ebelski/rust-copter/(list of files, cad)

Other CAD files:
solid-models/motor-test-fixture/motor_test_fixture.step
solid-models/motor-test-fixture/motor_test_fixture.stl
