ebelski/rust-copter/solid-models/motor-test-fixture/readme.md

solid models in this file are used for single motor testing so that the motor does not jump around on the bench or takeoff!
