ebelski/rust-copter/(threads)

Thread 5 (2020-03-18):

Reset to 0% throttle, not duty cycle

mciantyre, 2020-03-18:
In the `pwm-control` demo, pressing the SPACE bar commands 0% duty cycle, not 0% throttle. This is equivalent to removing the physical connection between the ESC and the controller. We're concerned that completely dropping the ESC input signal will cause a stall.

Update the SPACE bar to command 0% throttle, or 50% duty cycle. Move the kill switch to the backslash key, `\`.

Closed 2020-03-24.

Thread 7 (2020-06-04):

Running pwm-control.bat fails to produce hex file

ebelski, 2020-06-04:
@mciantyre , when running the hardware-test.bat file under the **demos** -> **pwm-control**, the compilation succeeds however the .hex file does not get produced. If the **hardware-test.sh** script is then executed directly after, the **out** folder with the associated hex file is correctly produced.

`The system cannot find the file specified.
Failed with error code 2.`

mciantyre, 2020-06-04:
Sorry I never tested the `hardware-test.bat` script!

Remove `@echo off` at the top of the script. Does that help identify where we're failing?

Couple of things we can manually check:

- show that `rmdir /S /Q out` works when `out` exists, and when `out` doesn't exist.
- show that `cargo build --release` creates a `target\thumbv7em-none-eabihf\release\pwm_control` file. If not, the `copy` command (line 14) is failing.
- try `arm-none-eabi-objcopy --help`. If it fails, we'll need to troubleshoot the toolchain installation.

ebelski, 2020-06-04:
We're failing on `rmdir /S /Q out` when out doesn't exist

ebelski, 2020-06-04:
I changed the line to read `if exist out rmdir /S /Q out || goto :error` and it looks like we're functional with or without the out directory existing.

mciantyre, 2020-06-04:
Awesome! I'll patch that upstream. Thanks for testing this.

Closed 2020-06-04.

Thread 8 (2020-06-04):

Use serial communication for PWM control demo

mciantyre, 2020-06-04:
We're having trouble using USB comms when connecting all the motors. Use UART as the communication mechanism.

ebelski, 2020-06-07:
Just as a follow up, I was able to get the USB comms working but it required me to plug the Power Supply into a different power outlet and plug the Teensy USB into a different USB outlet on my PC....

ebelski, 2020-06-10:
Do we still require the ability to communicate over UART? With USB back up and running I don't have a need for it currently.

ebelski, 2020-06-11:
Closing for now

Closed 2020-06-11.

Thread 9 (2020-06-04):

What serial communication cable do we need to communicate with the Teensy 4.0?

ebelski, 2020-06-04:
This one?

https://www.sparkfun.com/products/9717

ebelski, 2020-06-04:
https://www.adafruit.com/product/70

I ordered this one. Will reopen if necessary

ebelski, 2021-04-06:
Install the attached drivers to allow the cable to act as a virtual COM port. Link in the description to the drivers. Select the appropriate one for your OS and hardware.

Closed 2020-06-04.

Thread 13 (2020-06-10):

Error in task.py

ebelski, 2020-06-10:
```
python task.py demo pwm-control
error: Invalid character `{` in pkgid: `{crate}`
Traceback (most recent call last):
  File "task.py", line 165, in <module>
    args.func(args)
  File "task.py", line 114, in demo
    target = _cargo_build(crate, args.release)
  File "task.py", line 96, in _cargo_build
    subprocess.run(cmd, shell=True, check=True, env=env)
  File "C:\Anaconda3\lib\subprocess.py", line 418, in run
    output=stdout, stderr=stderr)
subprocess.CalledProcessError: Command 'cargo build --target thumbv7em-none-eabihf --release --package {crate}' returned non-zero exit status 101.
```

mciantyre, 2020-06-10:
Which version of Python is bundled with your Anaconda distribution?

```
python --version
```

Is it yelling about the f-string interpolation character, `{`? [f-strings](https://www.python.org/dev/peps/pep-0498/) are a Python 3.6 feature.

ebelski, 2020-06-10:
3.6.5.

It's not passing the actual crate name, instead it's getting a literal `{crate}` in the command line

ebelski, 2020-06-10:
I think the issue lies with line 96 in task.py?

mciantyre, 2020-06-10:
This is a good catch! Just reproduced on `master`. But, I can't reproduce it on the `feature/esc-protocols` brach...?

ebelski, 2020-06-10:
There was no `f` prefix in front of the string on line 93 so it should now read `    if crate:
        cmd += f" --package {crate}"`

I'm trying that to see if it works

mciantyre, 2020-06-10:
Looks like it! Want to push a fix? Otherwise I can grab it.

I'll add some automated tests that will run

```
python task.py demo pwm-control
```

on PRs, so these kinds of bugs don't happen again.

ebelski, 2020-06-10:
I'll push an update to the repo

Closed 2020-06-10.

Thread 15 (2020-06-10):

Print fixture to hold motor during OneShot testing.

ebelski, 2020-06-10:
The torque from the motor causes it to jump around on the desktop when spinning so it needs fixed in place to prevent damage to the electronics.

Closed 2020-06-10.

Thread 20 (2020-06-11):

Mount 3 motors simultaneously on the PDB and verify functionality

ebelski, 2020-06-11:

ebelski, 2020-06-11:
only testing 3 motors because one ESC is verified as bad.

ebelski, 2020-08-14:
I soldered the remaining 2 ESCs and motors to the PDB board. I powered on the Teensy and verified that each ESC powers on properly and then I commanded all motors to spin at 5% duty cycle. Everything functions well so far. I'll place an order for another ESC.

Closed 2020-08-14.

Thread 21 (2020-06-11):

Map PWM throttle percentages

ebelski, 2020-06-11:
Map PWM throttle percentages to current draw as measured by the power supply. Knowledge of the current drawn by the motor allows the force exerted by the motor/prop combo to be inferred

ebelski, 2020-06-11:
I created a spreadsheet to track this but don't know if it will upload well to github. @mciantyre if you have any suggestions for how to bring in a google sheet eloquently, that'd be much appreciated!

Otherwise, here's what I found.
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

I stopped at 55% throttle for 2 reasons. One, I have my power supply limited to 5.5 A current and I didn't want to saturate the supply. Two, this motor was getting pretty rowdy so I didn't want to push it just yet. I'm hoping that this half of the curve will be an ok approximation of the actual force/throttle curve.

Here's a chart of the current supplied vs. throttle percent.
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

So far it looks as if a 3rd order polynomial represents the curve rather well. The only doubts that I have in the data are from the specified parameters of the motor. It calls out for our setup (2300 KV, 14.8V, 5045 prop):

- a max current load of 27.6 A (the predicted current of 100% throttle is about 24 A or a 13% difference. I could be convinced that this is within their manufacturing tolerances, however I think it is due to nonlinear torque curves as the motor reaches its maximum rated current.)
- and corresponding to the maximum current, the maximum predicted pull in grams is only 814, not 950. (I don't know why this is specified in grams, it should be specified in Newtons in my opinion or at least mN) Again this could be a tolerance issue but is more likely a nonlinear relationship. We won't know unless we measure at 100% throttle, however I don't have a way to inject 27.6 A and measure it.

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

ebelski, 2020-06-11:
Even a rough model will be useful in developing a state estimator control scheme. Obviously the more accurate the model the better, but I think even a 13% discrepancy is something the control loop will be robust to.

mciantyre, 2020-06-11:
LGTM!

> have any suggestions for how to bring in a google sheet [...]

- If the document can be made public, we can add a link in this issue.
- We export the sheet as a CSV, and check that into the repo. We'll treat is as read only.
- Check in the raw data, and create a Python script to auto-generate the derived data and that plot.

Any option is good with me!

ebelski, 2020-06-11:
<iframe src="https://docs.google.com/spreadsheets/d/e/2PACX-1vRwAtvcS9hT733l32kDBAb9rSdvrcgj9SYalw7AGWiev5Jk97nK2Tfy6cE2jeu-qcLKq769bl4RLJjm/pubhtml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"></iframe>

ebelski, 2020-06-12:
This issue still bothers me slightly. We're relying on the specs from this manufacturer...which I don't outright trust. We can go the more robust route and actually measure the force with a load cell

- https://www.sparkfun.com/products/14729
- https://www.sparkfun.com/products/13879

and create a true calibration of throttle percentage to force. I don't actually think this is necessary but let's keep this idea in the back of our minds should we need a more accurate quadcopter model.

Closed 2020-06-12.

Thread 23 (2020-06-11):

Cleanup documentation

ebelski, 2020-06-11:
Document all of the progress made so far, clean up some of the descriptions in the readme, and begin laying out the wiki.

mciantyre, 2020-06-12:
Count me in. I have some other developer docs to add. I may add the following to the README, just as a reminder for us and for any newcomers:

## Generating source documentation

If you want to see the rendered in-source documentation, run

```
cargo doc --all --open
```

at the top of the repo. When the command finishes, it should open your browser with the documentation to a crate in the repo. Use the "Crates" column on the left to jump to the documentation for any other crate. Helpful crate docs include

- demo_pwm_control, which has the PWM pinout, and a depiction of how an ESC protocol is represented with a PWM signal
- teensy4_bsp, which has a sparse table describing the Teensy 4's pinout and pin functions

We put other software-related notes, tests, and examples in the source docs.  When we run tests, the compiler will check the tests and examples in the documentation for correctness. So by default, we're guaranteed that code samples in documentation are buildable. You'll never copy-and-paste broken code.

ebelski, 2020-06-12:
For sure!

What type of organization paradigm are you thinking for the source docs? Will those live as readmes in the repo?

ebelski, 2020-06-12:
Ultimately, once we get near the end of the build (much further in the future) I'd like for us to author a detailed paper on the process and methodology we took. So I'm game for any organizational scheme that is easy to interpret and useful.

mciantyre, 2020-06-12:
We'll want to keep detailed, module-level software docs in source code, as they are now. The `cargo doc` workflow is the de-facto way for sharing Rust code documentation.

For things like architectures, test plans and results, design docs, I see a few options:

- GitHub Wikis. Edit them in the browser. We can also [treat them as another git repo](https://help.github.com/en/github/building-a-strong-community/adding-or-editing-wiki-pages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), and edit the contents locally. Could be a good starting point.
- [Sphinx](https://www.sphinx-doc.org/en/master/) is flexible. I don't think it'd be something we would ever outgrow. It would help us organize and cross-reference our docs.
- If the goal is a paper, could start up-front with raw LaTeX! But, Sphinx also outputs LaTeX for PDF generation.

mciantyre, 2020-06-12:
On second thought, I might replace GitHub Wiki with “Markdown flies checked into the main repo.” It’s easier for us to version and release documentation with code, data, and models if it’s all in one repo. It’s also easier to look back and see how the project evolved through one version control history.

ebelski, 2020-06-12:
I like the idea of using markdown files stored and versioned in the main repo!

mciantyre, 2020-08-01:
mciantyre/teensy4-rs#74 shows that we can build and publish API documentation from a GitHub repo. The process publishes the content to https://mciantyre.github.io/teensy4-rs/. We could do something similar here. We'll need to figure out how it plays with the current GitHub pages publication.

Thread 24 (2020-06-12):

Develop test fixture for single motor pivot demo

ebelski, 2020-06-12:
The goal of the v0.1 milestone is to develop a demo that combines the motor control with sensor feedback from the mpu-9250.

In order to accomplish this goal we need a fixture to hold the motor at the end of a pivot as well as a pivot joint that can be affixed to the bench.

ebelski, 2020-09-18:
#29

ebelski, 2020-09-18:
https://cad.onshape.com/documents/092c9ad021a8f9693cfda00a/w/540c3cb33ba7e44cbc012b26/e/5458e5c9358795ed5e9bfd87

ebelski, 2021-04-08:
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

ebelski, 2021-05-03:
Constructed arm fixture out of cardboard and a dowel rod.
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

ebelski, 2021-09-20:
The cardboard was actually too heavy. Once I determine the length of each arm of our airframe and cut them, I'll use one of the arms (carbon fiber tube) to test the single motor pivot.

Closed 2023-04-21.

Thread 28 (2020-08-14):

Solder final ESC and motor into PDB

ebelski, 2020-08-14:
Once the spare ESCs arrive, solder the final ESC onto the PDB and test its functionality.

ebelski, 2020-08-17:
Soldered in the last motor and ESC! We're up and running and I verified all motors spin simultaneously

Closed 2020-08-17.

Thread 39 (2021-04-06):

Issue with teensy_loader_cli

ebelski, 2021-04-06:
I downloaded the teensy_loader_cli mentioned in the readme and ran into the following issue running both the cli by itself as well as the task.py.
```bash
python task.py demo pwm-control
    Finished release [optimized] target(s) in 0.02s
Unknown MCU type "TEENSY40"
Supported MCUs are:
 - at90usb162
 - atmega32u4
 - at90usb646
 - at90usb1286
 - mkl26z64
 - mk20dx128
 - mk20dx256
 - mk66fx1m0
 - mk64fx512
 - TEENSY2
 - TEENSY2PP
 - TEENSYLC
 - TEENSY30
 - TEENSY31
 - TEENSY35
 - TEENSY36
Traceback (most recent call last):
  File "task.py", line 166, in <module>
    args.func(args)
  File "task.py", line 117, in demo
    if not args.flash or not _flash(hex_file):
  File "task.py", line 58, in _flash
    subprocess.run(cmd, shell=True, check=True)
  File "/usr/lib/python3.8/subprocess.py", line 512, in run
    raise CalledProcessError(retcode, process.args,
subprocess.CalledProcessError: Command 'teensy_loader_cli --mcu=TEENSY40 -w -v target/thumbv7em-none-eabihf/release/demo-pwm-control.hex' returned non-zero exit status 1.
```

Is there a way to update the version of the cli to support 4.0?

ebelski, 2021-04-06:
I should also add that I tried specify the mcu as `--mcu=imxrt1062` as well

ebelski, 2021-04-06:
I'm closing this for now. I'm going to development on windows but after we reach a somewhat steady state, maybe v0.2 or v0.3, I'd like to run through setting this up on linux.

mciantyre, 2021-04-06:
See [their project](https://github.com/PaulStoffregen/teensy_loader_cli)'s issue tracker. I'm not sure they're releasing prebuilt binaries with Teensy 4 support right now.

It's a quick build from source. The dependencies for Ubuntu are listed under "Compiling from Source":

```
sudo apt-get install libusb-dev
git clone https://github.com/PaulStoffregen/teensy_loader_cli.git
cd teensy_loader_cli
git checkout 0a9ad5f
make
```

After that, you should find `teensy_loader_cli` in the directory. Try listing MCUs:

```
./teensy_loader_cli --list-mcus
```

mciantyre, 2021-04-06:
If there's still issues, the [graphical loader application](https://www.pjrc.com/teensy/loader.html) should work on Linux.

ebelski, 2021-04-06:
I was still running into issues with the graphical loader on Ubuntu but I think it is an issue on my part. I've reverted to using Windows and everything is working for me now.

Closed 2021-04-06.

Thread 42 (2021-04-08):

Milestone 0.1 demo program

ebelski, 2021-04-08:
In order to reach milestone 0.1 we need to be able to demonstrate single motor control based on sensor readings from the MPU-9250. The physical setup will be a lever attached to the desk via a pivot with a motor, propeller, and sensor at the end. The motor/prop will move the lever up and down. We need an example rust demo with the following program flow

- Allow serial input from the command line to choose which gyro axis sensor reading we would like to use as feedback
- Allow serial input for the command line to set the PID gains
- Start the demo with a keystroke and wait for input as the set point
- Allow serial input for the angle (in degrees) that we would like as the set point
    - It would be nice to be able to change the setpoint during the demo but not a requirement

Internal to the program we should:
- Create a control loop where the setpoint is in degrees and the sensor feedback is from the gyroscope.
    - We will need to integrate the velocity to estimate the position of the sensor
    - I will attach a control loop diagram to this issue detailing what we will need to implement

ebelski, 2021-04-08:
#24 shows what the demo fixture will look like

mciantyre, 2021-04-08:
We should re-review the MPU9250 driver code before this experiment, and make sure we can configure the sensor as needed. The current settings are arbitrary.

https://github.com/ebelski/rust-copter/blob/224c5096ab88c62965a70021c66d55af04bf8a7c/firmware/demos-teensy4/pwm-control/sensor.rs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

Where do we think the control loop needs to run? If it can run slowly on our host, we should have most pieces in place to run the experiment. Otherwise, if we need a faster loop, we might need to move it on board.

ebelski, 2021-04-09:
I think, in order to prove out what we eventually might do, that we'll want to get all of the 9 dof readings. Even though we'll only be using the gyro for this demo (at least initially), the quadcopter will likely be using the Madgwick filter or some equivalent where the Magnetometer will important for low frequency correction. By including these readings in the MPU-9250 polling it will give us some insight into what type of latency we can tolerate for the control loop (slower readings = more sluggish response of quadcopter to disturbances).

Is there the possibility of polling the sensor for the different readings at different rates? (e.g. Accel at 2000 Hz, Gyro at say 250 Hz , and Mag at 4 Hz (or whatever the max rate is)) Or are we locked into the slowest rate for all sensors?)

Depending on the answer to the above question, I think it will dictate where we should run the control loop. Another consideration will be the ability to ensure a quasi-deterministic sample rate for the control loop. If host or client side is able to keep time more accurately, we'll probably want to use that unless we have a compelling reason not to.

ebelski, 2021-04-09:
Do we know what the latency of sending sensor measurements from the Teensy to the host over serial would be?

For prototyping purposes, it'd be easier to run the control loop host side in python but I worry about latency. We'd need to pipe the sensor readings from the client to the host, process them, and then send back motor throttle commands. We can definitely give this a shot as I think the development time is relatively low and it will give us an idea if the latency is acceptable.

We would need the following capability in a .hex script

- Pipe accel and gyro readings from the Teensy to my PC
- At the same time read motor throttle commands from my PC and apply them to the respective motor (we only need to actuate 1 motor for this demo)
- (I guess technically this could be done sequentially, where one fires off and waits for a reply before firing again)

We would need the following capability in a python script

- Consume the accel and gryo readings from the Teensy
- Run a semi-deterministic rate control loop to produce a throttle output for the motor
- Pipe the throttle output to the Teensy
- Change the set angle setpoint based on keyboard input

From what we were testing in #29 we have a few of these already done. I can take care of the control loop development in python but I'm not sure how to write the Teensy code or negotiate the communication between the two.

> Where do we think the control loop needs to run? If it can run slowly on our host, we should have most pieces in place to run the experiment...

Based on the above, would it be relatively easy to write up the demo leaving a space for me to plug in the control loop code?

Also what do you think the max rate is that we can run the loop at given this architecture?

ebelski, 2021-04-09:
Green is host side in python and orange is client side in rust
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

mciantyre, 2021-04-10:
> Is there the possibility of polling the sensor for the different readings at different rates?

Yea we can do that. Right now, we're just polling all sensors at the same rate (100Hz) regardless of if the sensor changed. We'll need some changes to the demo's polling loop to support this, or create a better example with this in mind.

> Do we know what the latency of sending sensor measurements from the Teensy to the host over serial would be?

It's not that fast with the current settings.

- 115200 bits per second (baud rate)
- 10 bits per character (8N1: one start, one stop bit, plus 8 data bits)

means it takes `1 / 11520` seconds to send one byte of data.

Given the current serialization schema, 9DOF readings take up 42 bytes. This means it takes ~3.646ms to move 9DOF readings over the serial wire. That still has to go through your OS to reach your control loop. Of course we could tune this specifically for the experiment (variable sensor polling means fewer bytes on the serial wire, for example).

We could try switching the data flow to USB, instead of UART. I'd have to dig deeper into the implementation to see what our latency might be. But hopefully (without a driver change) we could move one 42 byte 9DOF reading every 125us (one bulk transfer every USB high speed microframe, see [here](https://microchipdeveloper.com/usb:frames)).

I can take care of exposing the data to Python, regardless of how it's moving from the board to your PC!

ebelski, 2021-04-12:
Honestly 3.646 ms or 274 Hz might be fast enough for what we're looking to do here in this demo but if we can get data faster that's always welcome! Because we're relying on the propeller/motor response time on a compressible fluid (air), there's probably some inherent speed limitation in how fast we can react to disturbances anyway. However, we'd always want the physics of the mechanical system to be limiting, not the electronics (i.e. blame the wrench monkey who designed the air frame...).

mciantyre, 2021-04-12:
Awesome. #43 makes the move from UART to USB. We're now only using UART for debug logs and human-readable outputs. IMU data streaming, and PWM throttle commands, go through USB.

#43 also adds a Python interface (`pypwm_control`) to stream IMU data, and control the motor throttle. Basic usage might resemble

```python
import pypwm_control

imu, motors = pypwm_control.open("COMx")  # Your COM port

# Disable magnetometer
imu.disable_readings(pypwm_control.ImuReading.Mag)

for reading in imu.stream():
    if type(reading) is pypwm_control.ImuReading.Acc:
        # Handle accelerometer readings
    elif type(reading) is pypwm_control.ImuReading.Gyro:
        # ...

    # Do math in here...

    # Do things with motors
    motors.motor("B").set_throttle(72)  # 72% throttle
```

How does that look for a host-side control loop?

ebelski, 2021-04-12:
Gucci, that's exactly what I was hoping for. Now to see how well I can tune this on the fly with no tools. I think this calls for the [Ziegler-Nichols tuning method](https://en.wikipedia.org/wiki/Ziegler%E2%80%93Nichols_method).

I'll start printing the fixturing for the motor today and plugging in some code.

ebelski, 2021-04-22:
I'm starting to test this but I'm unable to initialize the motor on the quadcopter. I'm using the pwm-control demo on the Teensy and running the following script (which is pretty much what you pseudo coded above)
```python
import pypwm_control

imu, motors = pypwm_control.open("COM3")  # Your COM port

# Disable magnetometer
imu.disable_readings(pypwm_control.ImuReading.Mag)

for reading in imu.stream():
    if type(reading) is pypwm_control.ImuReading.Acc:
        # Handle accelerometer readings
        print(reading)
    elif type(reading) is pypwm_control.ImuReading.Gyro:
        print(reading)

    # Do math in here...

    # Do things with motors
    motors.motor("B").set_throttle(15)  # 72% throttle
```

For the time being I'm just using this to make sure the motor will respond to my inputs. I have everything connected to the power supply and it gives me the startup beep but doesn't give me the connected protocol beep between the ESC and Teensy.

In #12 I recall this working pretty well. Did something change in the firmware that prevents initialization?

ebelski, 2021-04-22:
I'm also trying to use ```esc-throttle.py``` to test the motors and not getting a response from the motor. For reference I'm connected to pin 7 or motor B.

mciantyre, 2021-04-23:
I'm sorry, I'll admit that I haven't tested PWM in a while 😝 I can confirm that PWM output is broken in all of the `rust-copter` code. It's even broken in the [teensy4-rs examples](https://github.com/mciantyre/teensy4-rs).

I think I found the problem in the PWM driver. Once I finish testing, I'll upstream the fix, and propose a temporary patch here. Take a break until I follow up.

ebelski, 2021-04-23:
Ok no worries! I thought it was something I was doing. I'll wait until I hear back from you!

ebelski, 2021-04-23:
@mciantyre fixed this with #46. Progress shall continue! ♟️

ebelski, 2021-04-23:
The python AHRS package contains the Madgwick filter and other Attitude and Heading Reference Systems. pypi.org/project/AHRS/

ebelski, 2021-04-23:
@mciantyre, do you think we would be able to implement some of the AHRS algorithms on the Teensy? Like what Kris Winer has implemented for an Arduino?

https://github.com/kriswiner/MPU9250/blob/72038b040bef3cf072612cd8a8ee8f26e3c87158/MPU9250BasicAHRS.ino

I'd be interested in learning how to implement this if you'd be willing to show me?

Concurrently though I'm working on developing this in python for debugging purposes. So we can wait on this implementation until I iron out a few things regarding the stability of the Madgwick filter.

mciantyre, 2021-04-24:
> do you think we would be able to implement some of the AHRS algorithms on the Teensy? [...] I'd be interested in learning how to implement this if you'd be willing to show me?

Yea for sure! Happy to help you write it for the embedded system. There shouldn't be any problems running an AHRS filter on the board.

There's different ways we can take it:

- Write it all from scratch in either Rust, or C. We can use C code in Rust, and use Rust code in C. Pick whatever you want to learn.
- Use third-party libraries to help with our implementation (like [nalgebra](https://nalgebra.org)).
- Use an existing solution ([kalman filter](https://docs.rs/adskalman/0.8.0/adskalman/), [madgwick filter](https://docs.rs/madgwick/0.1.1/madgwick/)) and integrate it.

ebelski, 2021-09-20:
I ran into a few issues when I was working on the python side of this. I'm hoping to pick this back up again soon.

As an aside, the carbon fiber tubing for the air frame arrived yeserday 🎉

Thread 44 (2021-04-12):

Variable sensor sampling rates

mciantyre, 2021-04-12:
Our 0.1 demo queries all readings (accelerometer, gryoscope, magnetometer) from an MPU9250 at 100Hz. This happens

- regardless of the sensor sampling rate, which might be less than 100Hz
- even if we don't care about that sensor (i.e. we're not using the magnetometer)

There's no reason we're doing this, other than it was simple to put together.

A future embedded platform should support variable sensor sampling rates. This will let us express sensor reading strategies like "poll acc at 2KHz, gyro at 250Hz, and mag at 4Hz."

We should be able to change sampling rates during runtime, before takeoff. Supporting sampling rate changes during flight are not supported. Let me know if changing sensor sampling rates during flight might be useful. I'd need some help thinking through the details.

ebelski, 2021-09-20:
I don't think we need to vary sampling rates during flight. That'd be scary actually 😨 we'd probably get a situation like this

```
A 747 was flying along and was full of Polish people.
As they were going past some beautiful landmarks, the pilot came over
the intercom and instructed all who were interested in seeing the
landmark to look out the right side of the plane. Many
passengers did so, and the plane promply crashed. Why?
Too many poles in the right hand plane.
```

Thread 45 (2021-04-12):

Atomically set PWM outputs

mciantyre, 2021-04-12:
I believe the i.MX RT PWM peripherals could let us set PWM duty cycles atomically across a single peripheral's outputs. This could give us a guarantee that, when we say "set *all* motor throttles to [value]" we've changed the duty cycle for all PWM outputs at *exactly* the same time (within the bounds of a PWM cycle).

We can't express atomic changes with today's driver. We can only loop over the *N* outputs, and set them all to the same throttle. With this API, there's a chance that the first few motors are set to the throttle before the other motors.

This issue tracks atomic changes to PWM outputs.

- [ ] Re-evaluate the peripheral, and see if it's feasible
- [ ] Figure out if this feature is necessary
- [ ] Implement it

mciantyre, 2021-04-12:
Our `ESC` interface already has an API for atomic changes. The default implementation just does the non-optimal loop. If we think that this feature is necessary, let's make sure to design to that API.

https://github.com/ebelski/rust-copter/blob/b12f95fa99cb61595e41ef21fce39d01f53f29ec/common/esc/src/lib.rs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

mciantyre, 2021-04-12:
I'm on the fence between must-have and nice-to-have for this feature. If we were directly driving motors with our PWM outputs, I'd say this is very useful. But, since we're talking to a different ESC today, and we don't control the behaviors on that ESC, I'd think that atomic PWM changes on our end would be an over-optimization.

In practice, I'd expect a loop to set the PWM outputs to happen so fast that it's basically atomic (should verify this). We could prevent software preemption with a critical section.

ebelski, 2021-09-20:
Did you have something in mind for verifying this? Such as connecting it to a logic analyzer?

mciantyre, 2021-09-21:
First thing to verify is that the chip supports a way to atomically set the PWM outputs. Given the description from the fields in this PWM MCTRL register (image below), my interpretation is "yes." I still need to dig in.

Each PWM peripheral supports eight outputs (four submodules, each driving two pins). So to set the values across all eight simultaneously, the flow resembles

1. write `0b1111` to `CLDOK`, or wait for `LDOK` to read zero.
2. [set PWM values for all four outputs in other registers]
3. write `0b1111` to `LDOK`

Once 3 happens, the peripheral loads the PWM values for all outputs, and starts driving with the new values.

Showing this happens with a logic analyzer would be good evidence. But, it wouldn't be complete verification. Today, we can show that we appear to be changing all PWM outputs at the same time; we're lucky.

I'll look into this as I play with the HAL. Could be cool to implement, but still not convinced we need it for today's system.

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

ebelski, 2021-09-23:
I tend to agree that we don't need this. Since we prove (or can prove) that they're setting roughly at the same time, I think that's good enough.

When we start to load the Teensy with more processes we will want to verify this doesn't change.

Thread 47 (2021-04-23):

Revert #46

mciantyre, 2021-04-23:
In #42, Eric found a bug in the PWM driver. We patched it in #46. Revert #46 once the fix is in the upstream HAL, so that we don't have to maintain our own PWM pin multiplexing code. Re-run testing when reverting.

Closed 2021-04-23.
