ebelski/rust-copter/(commit log)

2020-02-02 Add PWM control example
    Use the USB serial connection to command PWM duty cycles.
    As of this commit, only pins 6 and 9, called outputs A and D,
    are implemented.
2020-02-02 Add blinking LED to show something is happening
2020-02-02 Require users to submit a valid percentage
    Don't automatically clamp the percentage. If the user accidentally
    hits an extra '1' when typing '11', that becomes 100%, instead of
    throwing an error about it being out of range. Let's make the user
    enter it again.
    [parser.rs]
2020-02-05 Add remaining PWM outputs; add LED blink
    LED blinks based on the fastest PWM duty cycle. The higher the duty
    cycle, the faster the blink.
2020-02-12 Add PWM kill switch
    Press the SPACE bar to set all PWM outputs to 0%.
2020-02-12 Update MPU example
    Pull in changes from Teensy 4 repo
2020-03-15 Update PWM control demo for ESC PWM protocol
    The commit updates the PWM control demo to command ESCs. It should
    provide an implementation of the standard PWM signal described in
    https://quadmeup.com/pwm-oneshot125-oneshot42-and-multishot-comparison/
    Our ESCs are documented as supporting this PWM protocol. This is not
    the fastest ESC protocol our processor can support; however, it was
    the easiest to implement and verify with a logic analyzer.
    Note that pressing the SPACE bar sets the duty cycle to 0, not the
    throttle percentage. SPACE still acts as a kill switch. But, we set
    the throttle percentage to 0 during start-up.
2020-03-15 Fix logic for converting duty to percentages
    [main.rs]
2020-03-18 Indicate when a motor is disabled
    Pressing the SPACE bar disables all outputs. The commit updates
    the read duty command so that disabled outputs are indicated
    as being DISABLED.
2020-03-18 Reset to 0% throttle, not 0% duty cycle
    [main.rs, parser.rs]
2020-03-18 Add software kill switch
    Pressing the '\' key will set all PWM duty cycles -- not throttles --
    to 0%, and stop the event loop. The user will be required to reset
    the system.
    [main.rs, parser.rs]
2020-06-05 Add ESC interface and naive i.MX RT implementation
2020-06-05 Integrate ESC into pwm-control demo
    Note the updated PWM output table! The motor identifies have changed
    to support the limitations in the ESC implementation.
    Tested as follows:
    - All PWM outputs start at 50% duty cycle (0% throttle)
    - Table of PWM outputs to pins appears to be correct
    - Moved a lead on the logic analyzer one by one, changed the pin
    duty cycle, then read that duty cycle.
    - Pressing 'r' shows the correct duty cycle
    - Pressing 'SPACE' sets throttle to 0%
    - Kill switch still kills
    [main.rs, parser.rs]
2020-06-05 Migrate to a top-level task script
    The new task.py Python script replaces the various hardware-test.sh
    and hardware-test.bat scripts. It's run from the top of the
    repository:
    ./task.py demo pwm-control
    It requires Python 3. See the script's top-level documentation for
    more examples and help.
2020-06-09 Implement additional ESC protocols
    - rename "slow" to "standard"
    - implement OneShot125
    - implement OneShot42
    Implementations just map to a PWM frequency. The ESC type then maps
    a throttle percentage to a duty cycle.
    Move the `kill()` method into the trait.
2020-06-09 Print ESC protocol when reading throttles
2020-06-10 Show that the 'demo-' prefix isn't necessary
    The actual crate names have a 'demo-' prefix. Even though, on the
    filesystem, the directory is called 'pwm-control', the Rust crate
    is called 'demo-pwm-control'. The script should handle missing
    prefixes, just to make it easier for users.
2020-06-10 Uploading motor test fixture step and stl files. Primary use is to secure the motor to the bench when testing it with a prop. Torque is pretty high even without the prop, so I recommend bolting down 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
    [motor_test_fixture.step, motor_test_fixture.stl]
2020-06-10 Track PDFs with git lfs
2020-06-11 Fix tag matching
    GitHub Actions don't support full regex. Here's the limited set of
    possible matches:
    https://help.github.com/en/actions/reference/workflow-syntax-for-github-actions#filter-pattern-cheat-sheet
2020-06-12 Create readme.md in motor-test-fixture folder
2020-06-12 Resolve merge conflict in .gitattributes
    Looks like we checked-in a merge conflict in the .gitattributes file,
    which is used by git lfs. It manifested when I pulled-down master,
    and my git client threw a fit about the motor test fixture files.
    [motor_test_fixture.step, motor_test_fixture.stl]
2020-06-20 Update dependencies
    We've release the next version of the hardware abstraction layer.
    This feeds into a new board support package for the Teensy 4. It's
    a good time for us to update our dependencies.
    Update followed
    cargo upgrade --workspace
    cargo update
2020-06-20 Fix the breaking change introduced in the new HAL
    See the HAL's changelog for more information:
    https://github.com/imxrt-rs/imxrt-rs/blob/master/imxrt-hal/CHANGELOG.md#changed
    [main.rs]
2020-07-01 Update to latest version of teensy4-bsp
2020-07-04 Begin MPU9250 driver
    There's a SPI driver with many TODOs
2020-07-10 Commit unfinished prototype
    The SPI driver doesn't work at the moment. I'm considering a fork of
    the MPU9250 Rust driver that I'm familiar with. We should be able to
    adapt it for our needs.
    [main.rs]
2020-07-11 Reimplement a begin function for SPI
    Still no polling I2C master yet, but it comes up repeatedly.
2020-07-11 Finish prototype SPI driver
    It's sampling raw values, but we're not doing any conversions or
    configurations at the moment.
2020-07-11 Implement I2C MPU driver
    Still reading raw values. But, the raw values are consistent across
    both driver implementations.
2020-07-11 Add a from_handle i2c function; docs
2020-07-11 Integrate magnetometer configuration and scaling
2020-07-12 Correct for magnetometer axes
2020-07-12 Add SPI configuration interface
2020-07-26 Update APIs for the new IOMUXC driver
2020-08-15 motion-sensor: add reading serialization support
2020-08-15 demos: implement pwm-control datapath
2020-08-15 demos: add IMU polling to pwm-control
2020-08-15 Add Python bindings for motion sensor data parsing
    [lib.rs]
2020-08-16 Add POC IMU data parser in Python
2020-08-16 Update pwm-control docs
2020-08-29 Update all dependencies
    This includes the new teensy4-bsp API, which supports the Teensy 4.1.
    It also includes the 0.4 release of the HAL.
2020-08-29 Skip build dependency installation
    We removed this requirement from the teensy4-bsp a little while ago.
    Users shouldn't need these tools to build the BSP.
2020-10-16 Update project to use teensy4-bsp 0.1 release
    I held off for a while on a formal BSP release. The BSP was using
    some custom libraries that made it incompatible with the rest of
    the embedded Rust ecosystem. Recent learnings have shown ways to
    overcome those incompatibilities, so I was able to publish a
    real release.
    The PR updates all tools in this project to use the new, public
    release of the BSP.
    Tested by building the `pwm-control` demo, and flashing it on my
    board.
    https://crates.io/crates/teensy4-bsp
    https://docs.rs/teensy4-bsp/0.1.0/teensy4_bsp/
    [main.rs]
2021-01-23 Favor rust-objcopy from cargo binutils
    The teensy4-rs project no longer requires a separate ARM toolchain
    and binutils. Instead, the project recommend using cargo binutils
    and the LLVM tools. This commit updates our task script to use the
    same tools.
2021-01-23 Remove ARM toolchain install in CI
    We no longer need the ARM compiler, binutils, or newlib. There are no
    more C sources, and we're using cargo binutils. This commit removes
    the install step in our testing jobs.
    One fewer step should save us some time and energy.
2021-01-23 Add CI for host-side tooling
    Make sure pymotion-sensor builds, installs, and can be imported by
    Python. Do that across three recent Python versions, and three hosts.
2021-01-23 Add tools/pymotion-sensor to lint, format checks
2021-01-23 Manually build and install pymotion-sensor
2021-04-05 Allow upper-case acronyms in MPU9250 driver code
    It's helpful for consistency with the reference manual, even though
    it disagrees with Rust's best practices.
2021-04-07 Implement retry and flush loop in imu-parse
2021-04-08 Fix doctests in invensense-mpu
    [i2c.rs, spi.rs]
2021-04-10 Move datapath into UART module
    The next commit will introduce a USB datapath that's API compatible
    with the UART datapath...
2021-04-10 Move pwm-control datapath to USB; log over UART
    Integrate the imxrt-uart-log crate for logging over UART. The
    imu-parse.py script continues to work. You now point the script
    at your USB serial port, not the FTDI serial port.
    Open a serial connection, baud rate 115200, with the FTDI cable to
    monitor logs. UART pinout is the same.
    As of this commit, the pwm-control datapath and motor control both
    run over USB. The board's serial receiver does nothing.
2021-04-10 Add pypwm_control Python package
    The pypwm_control package provides a Python interface to the
    pwm-control demo example for the embedded system. Use this to create
    a host-side control loop.
    Update the imu-parse.py example to use pypwm_control's ImuStream
    abstraction. See the update tool for a demonstration of IMU reading
    and filtering.
    Tested the PwmControl interface from the new esc-throttle command-
    line utility. Did not measure PWM outputs, but I observed that the
    LED blinks at different frequencies, depending on the maximum
    throttle.
2021-04-10 Document pypwm_control, esc-throttle in README
2021-04-10 Update pwm-control top-level docs
    Indicate that motion readings are now available from the USB
    bus, not the UART interface. Add a new section for debugging I/O.
2021-04-23 Set PWM pin muxing in pwm-control example
    Revert this commit when the 0.4.4 imxrt-hal is available.
    [lib.rs, main.rs]
2021-04-23 Revert "Set PWM pin muxing in pwm-control example"
    This reverts commit d5590677e29d5a5b5f0730edf2ad70c4b2ade2bb.
    See #47 for details.
    [lib.rs, main.rs]
2021-04-23 Bump imxrt-hal dependency requirement to 0.4.4
    Fixes the PWM regression that we were manually patching. Tested by
    hooking up an LED to a PWM output, and observing that the intensity
    changed as a function of throttle.
    Closes #47.
2021-04-24 Replace error log, spin loop with panic!
    Same effect, just less to type.
    [main.rs, mpu9250-i2c.rs, mpu9250-spi.rs]
2021-04-24 Implement custom panic handler with error logging
    [lib.rs, main.rs, mpu9250-i2c.rs, mpu9250-spi.rs]
